yash101/tpbot/electronics/telepresence-bot.pdf

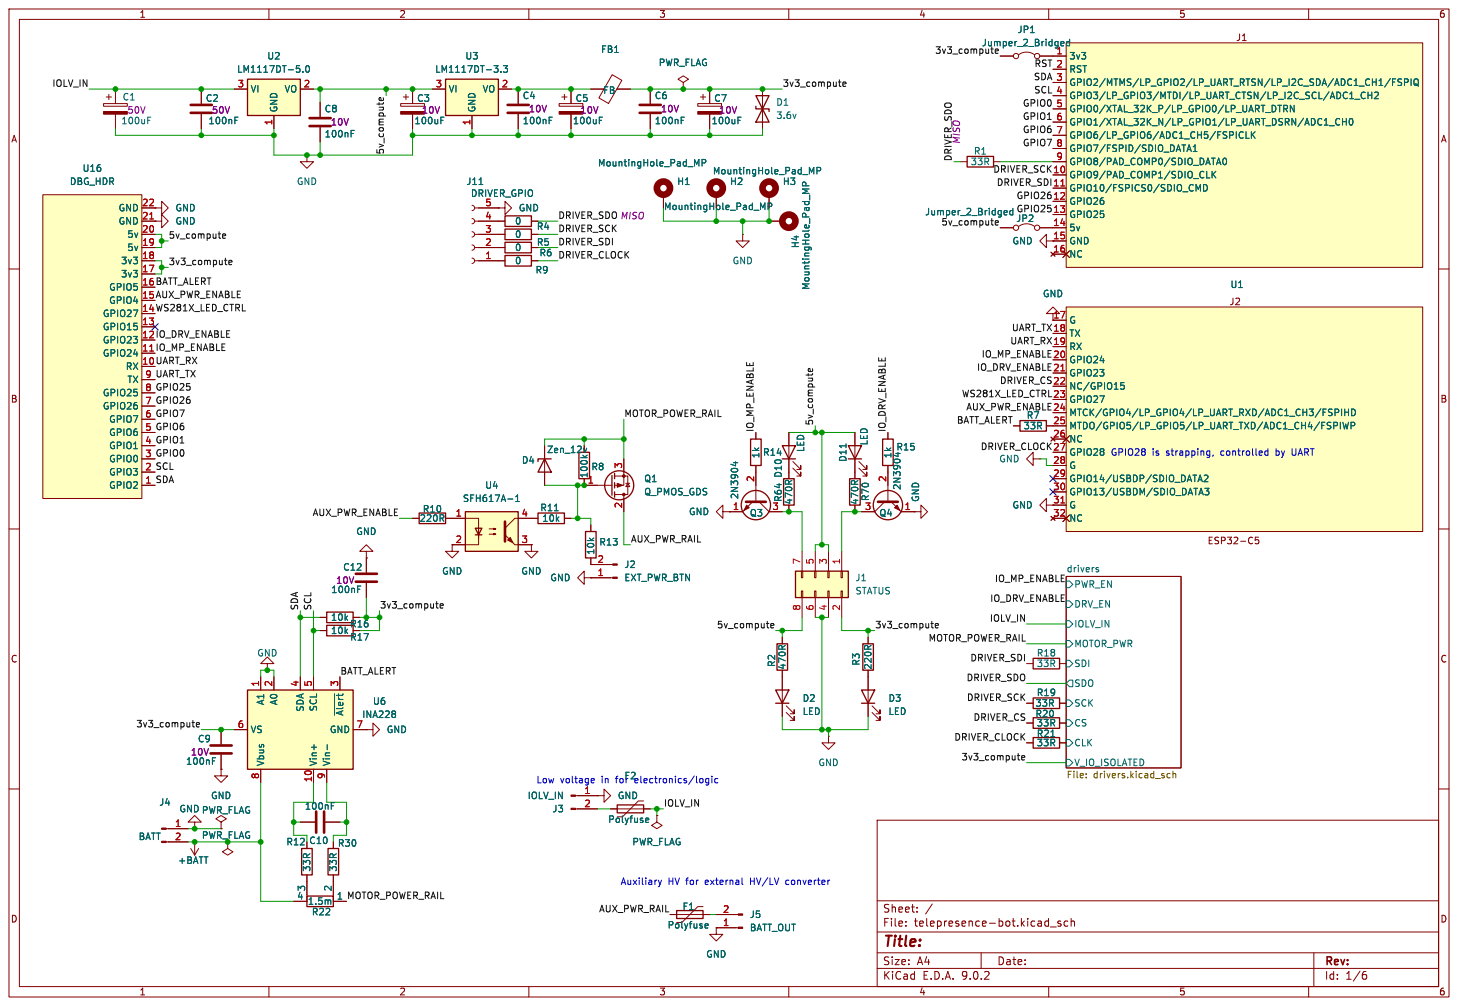
[picture p1: page 1]

3v3 1 RST 2 GPIO2/MTMS/LP_GPIO2/LP_UART_RTSN/LP_I2C_SDA/ADC1_CH1/FSPIQ 3 GPIO3/LP_GPIO3/MTDI/LP_UART_CTSN/LP_I2C_SCL/ADC1_CH2 4 GPIO0/XTAL_32K_P/LP_GPIO0/LP_UART_DTRN 5 GPIO1/XTAL_32K_N/LP_GPIO1/LP_UART_DSRN/ADC1_CH0 6 GPIO6/LP_GPIO6/ADC1_CH5/FSPICLK 7 GPIO7/FSPID/SDIO_DATA1 8 GPIO8/PAD_COMP0/SDIO_DATA0 9 GPIO9/PAD_COMP1/SDIO_CLK 10 GPIO10/FSPICS0/SDIO_CMD 11 GPIO26 12 GPIO25 13

5v 14 GND 15 NC 16 G
31 NC 32 GND
17 TX 18 RX 19 GPIO24 20 GPIO23 21 NC/GPIO15 22 GPIO27 23 MTCK/GPIO4/LP_GPIO4/LP_UART_RXD/ADC1_CH3/FSPIHD 24 MTDO/GPIO5/LP_GPIO5/LP_UART_TXD/ADC1_CH4/FSPIWP 25 NC 26 GPIO28 27 G

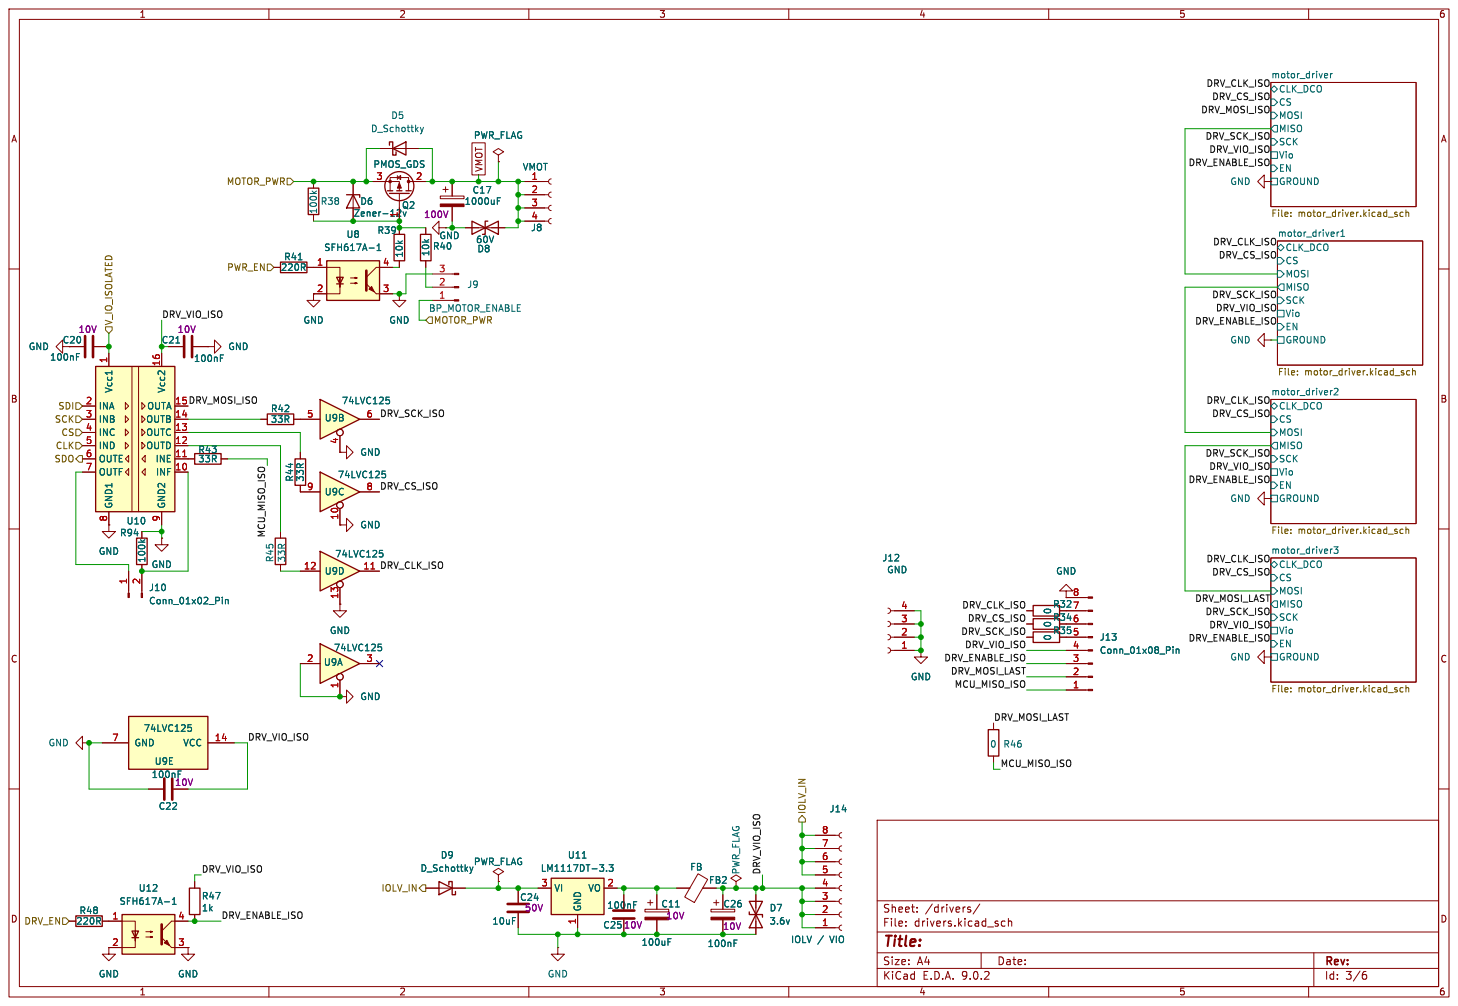
[picture p2: page 2]

9 OUTA 15 OUTB 14 OUTC 13 OUTD 12

Id: 3/6 Title: File: drivers.kicad_sch Sheet: /drivers/

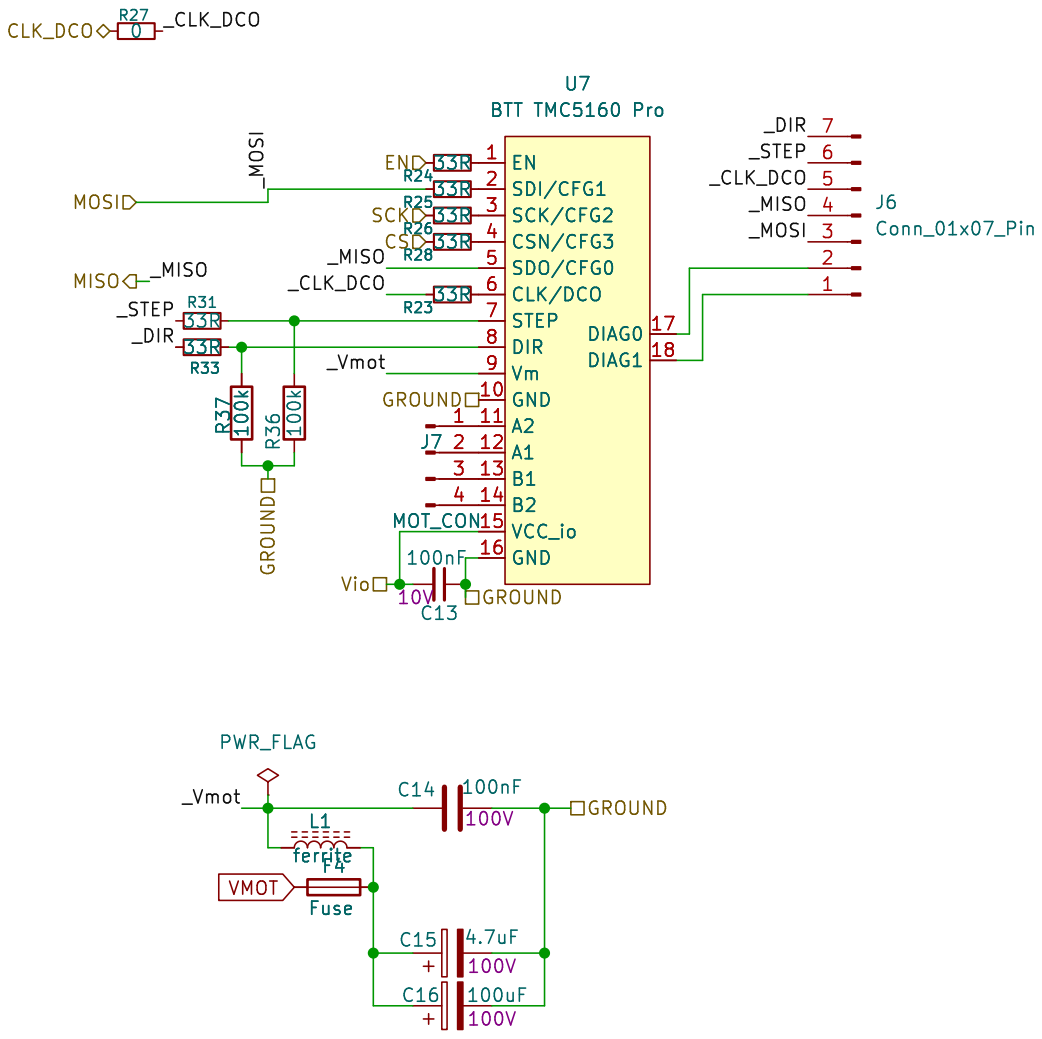
[picture p3: page 3]

Id: 2/6 Title: File: motor_driver.kicad_sch Sheet: /drivers/motor_driver1/

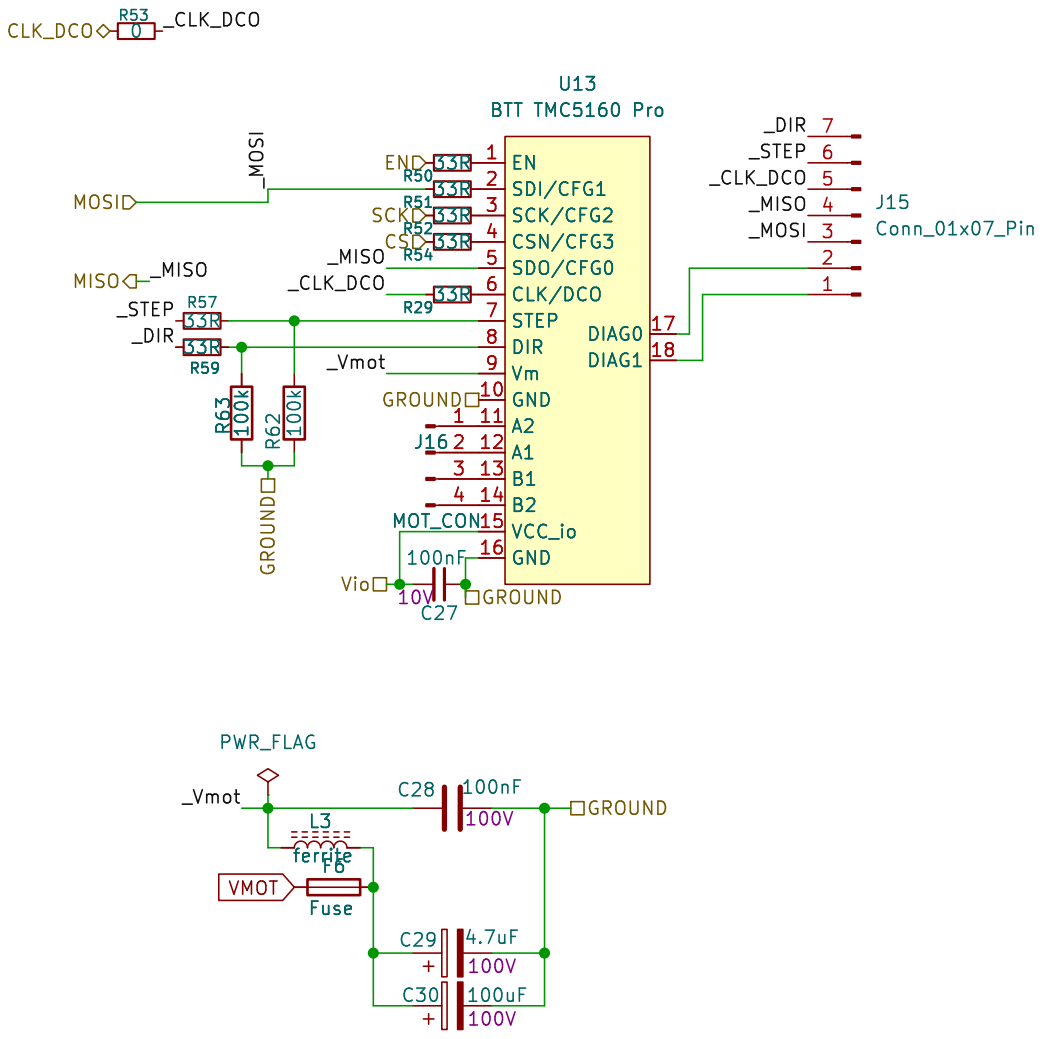
[picture p4: page 4]

Id: 3/6 Title: File: motor_driver.kicad_sch Sheet: /drivers/motor_driver/

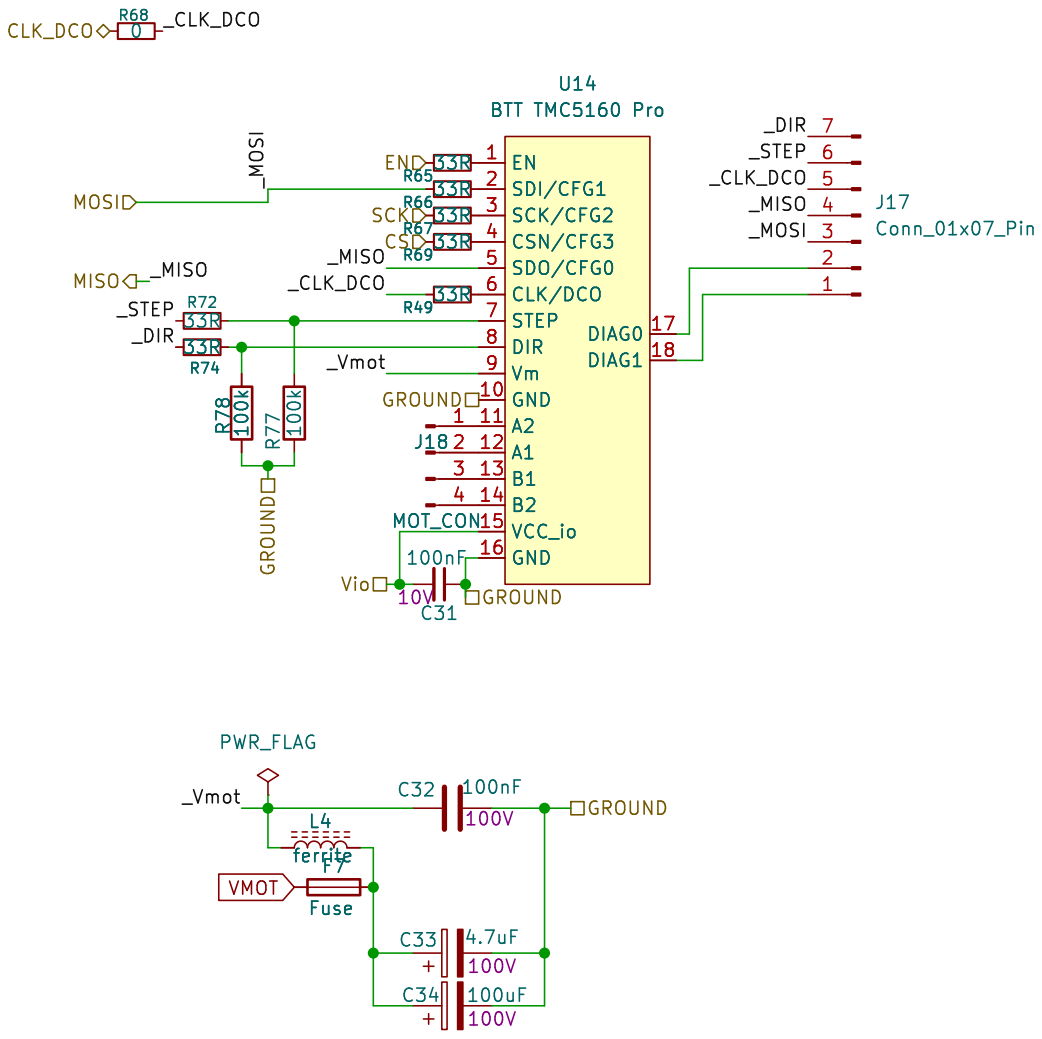
[picture p5: page 5]

Id: 4/6 Title: File: motor_driver.kicad_sch Sheet: /drivers/motor_driver2/

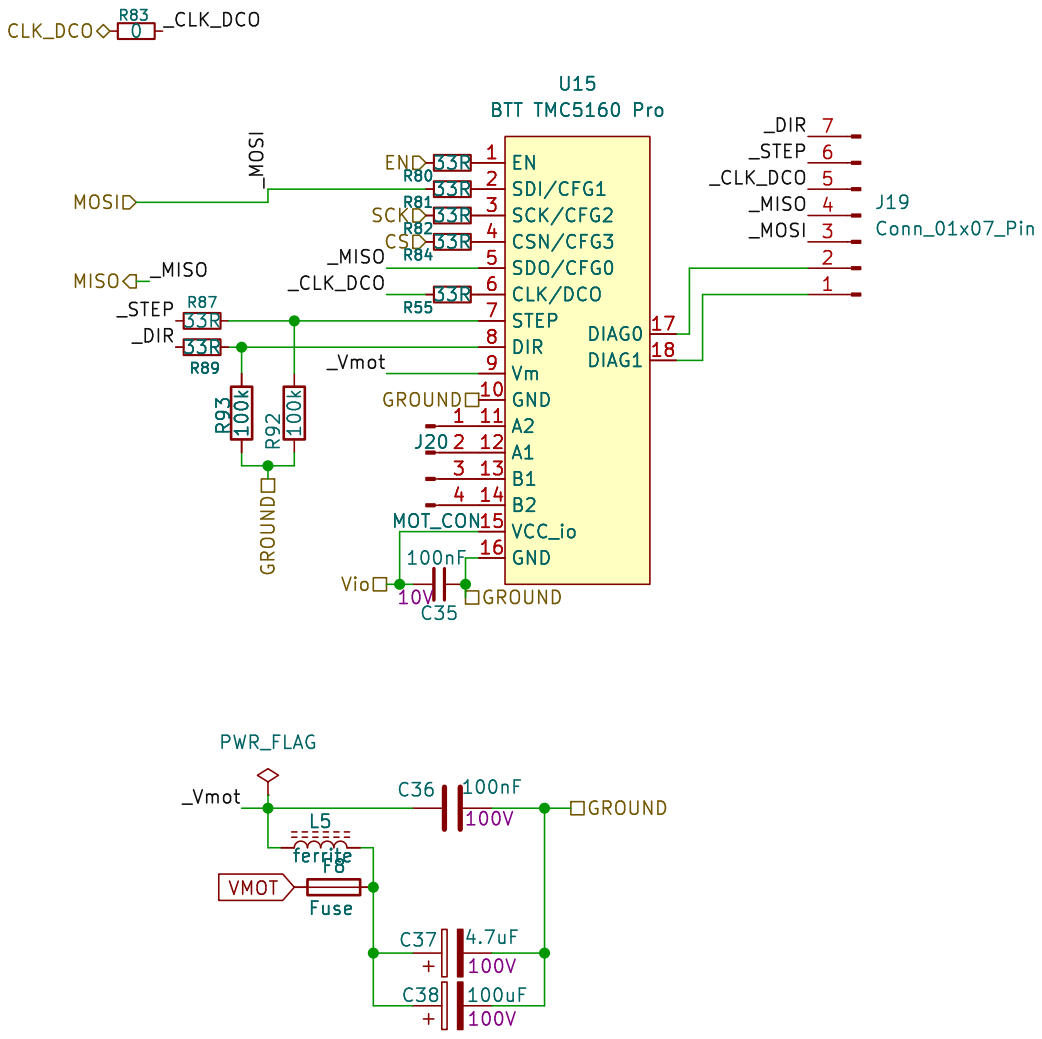
[picture p6: page 6]

Id: 5/6 Title: File: motor_driver.kicad_sch Sheet: /drivers/motor_driver3/
