yash101/tpbot/electronics/telepresence-bot.kicad_pcb

## KiCad design electronics/telepresence-bot.kicad_pcb (2025-08-20)

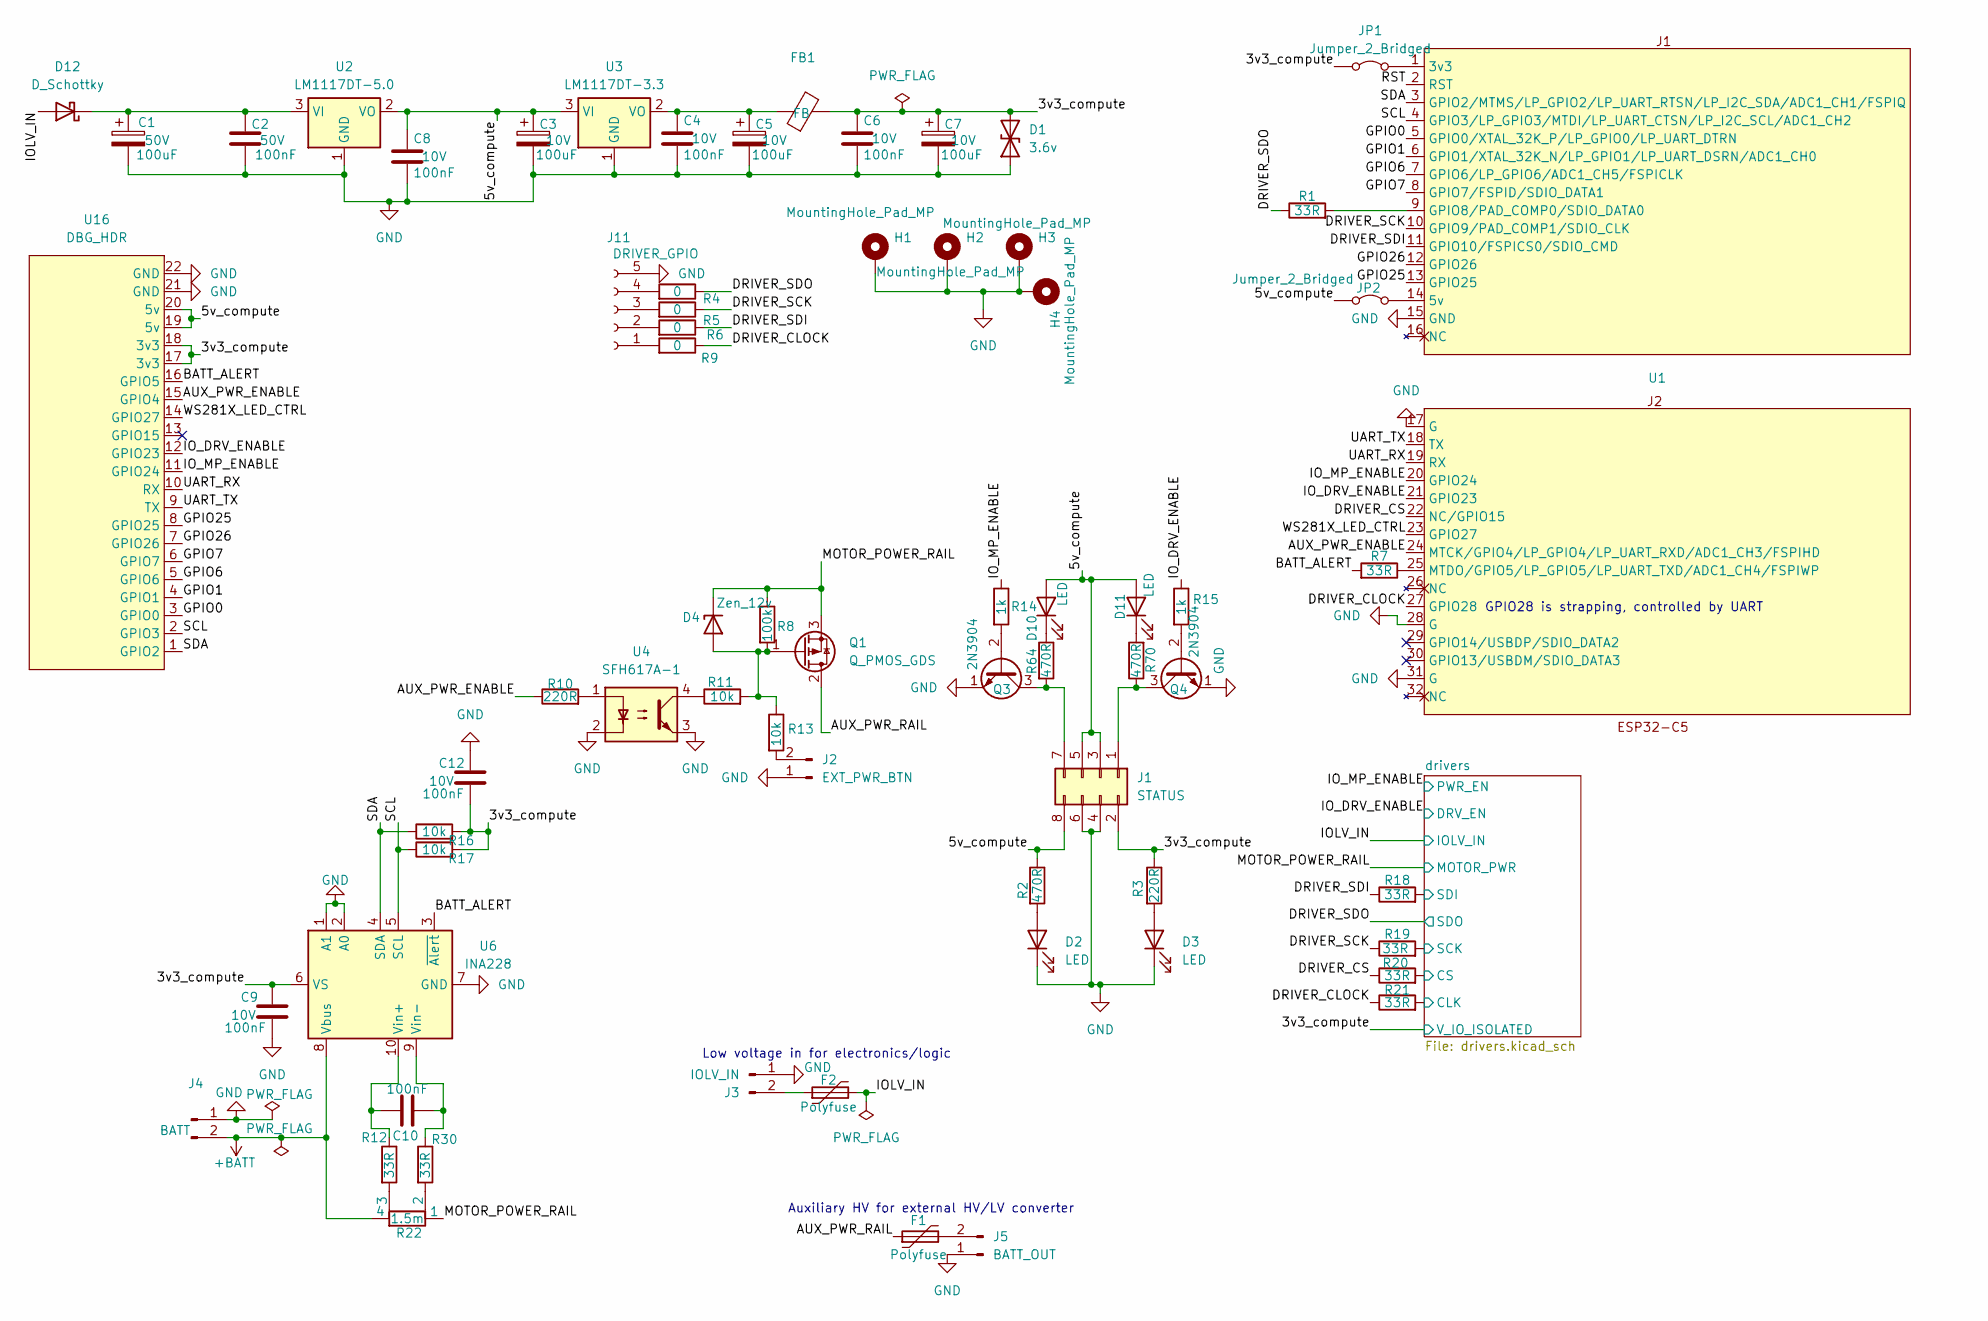
[picture p7: schematic telepresence-bot.kicad_sch]

Parts:
C1: 100uF; CP_Radial_D8.0mm_P5.00mm
C2, C10: 100nF; C_1206_3216Metric_Pad1.33x1.80mm_HandSolder
C3, C5, C7: 100uF; CP_Radial_D6.3mm_P2.50mm
C4, C6, C8, C9, C12: 100nF; C_0805_2012Metric_Pad1.18x1.45mm_HandSolder
D1: 3.6v; D_DO-41_SOD81_P2.54mm_Vertical_AnodeUp
D2, D3, D10, D11: LED; LED_D3.0mm
D4: Zen_12v; D_DO-41_SOD81_P2.54mm_Vertical_AnodeUp
D12: D_Schottky; D_DO-201AD_P5.08mm_Vertical_KathodeUp
F1, F2: Polyfuse; RV_Disc_D9mm_W5.2mm_P5mm
FB1: FB; L_1210_3225Metric_Pad1.42x2.65mm_HandSolder
H1, H2, H3, H4: MountingHole_Pad_MP; MountingHole_4.3mm_M4_ISO7380
J1: STATUS; PinSocket_2x04_P2.54mm_Vertical
J2: EXT_PWR_BTN; PinHeader_1x02_P2.54mm_Vertical
J3: IOLV_IN; PinHeader_1x02_P2.54mm_Vertical
J4: BATT; BATT_CONNECTOR
J5: BATT_OUT; PinSocket_1x02_P2.54mm_Vertical
J11: DRIVER_GPIO; PinSocket_1x05_P2.54mm_Vertical
JP1, JP2: Jumper_2_Bridged; PinSocket_1x02_P2.54mm_Vertical
Q1: Q_PMOS_GDS; TO-220-3_Vertical
Q3, Q4: 2N3904; TO-92_Inline_Wide
R1, R7, R12, R18, R19, R20, R21, R30: 33R; R_0805_2012Metric_Pad1.20x1.40mm_HandSolder
R2, R64, R70: 470R; R_Axial_DIN0204_L3.6mm_D1.6mm_P1.90mm_Vertical
R3, R10: 220R; R_Axial_DIN0204_L3.6mm_D1.6mm_P1.90mm_Vertical
R4, R5, R6, R9: 0; SolderJumper-2_P1.3mm_Open_Pad1.0x1.5mm
R8: 100k; R_0805_2012Metric_Pad1.20x1.40mm_HandSolder
R11, R13, R16, R17: 10k; R_0805_2012Metric_Pad1.20x1.40mm_HandSolder
R14, R15: 1k; R_Axial_DIN0204_L3.6mm_D1.6mm_P1.90mm_Vertical
R22: 1.5m; R_Shunt_Vishay_WSKW0612
U1: ESP32-C5-DevKitC-1-v1.2
U2: LM1117DT-5.0; TO-220-3_Vertical
U3: LM1117DT-3.3; TO-220-3_Vertical
U4: SFH617A-1; DIP-4_W7.62mm
U6: INA228; VSSOP-10_3x3mm_P0.5mm
U16: DBG_HDR; PinSocket_2x11_P2.54mm_Vertical

Connections:
+BATT: J4.2, R22.4, U6.8 (Vbus)
/3v3_compute: C6.1, C7.1, C9.1, C12.2, D1.2 (A2), FB1.2, J1.2, JP1.1 (A), R3.1, R16.2, R17.2, U6.6 (VS), U16.17 (3v3), U16.18 (3v3); also elsewhere on the board
/5v_compute: C3.1, C8.1, D10.2 (A), D11.2 (A), J1.3, J1.5, J1.8, JP2.1 (A), R2.1, U2.2 (VO), U3.3 (VI), U16.19 (5v), U16.20 (5v)
/AUX_PWR_ENABLE: R10.1, U1.24 (MTCK/GPIO4/LP_GPIO4/LP_UART_RXD/ADC1_CH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), U16.15 (GPIO4)
/AUX_PWR_RAIL: F1.1, Q1.2 (D)
/BATT_ALERT: R7.2, U6.3 (~Alert), U16.16 (GPIO5)
/DRIVER_CLOCK: R9.1, R21.1, U1.27 (GPIO28)
/DRIVER_CS: R20.1, U1.22 (NC/GPIO15)
/DRIVER_SCK: R5.1, R19.1, U1.10 (GPIO9/PAD_COMP1/SDIO_CLK)
/DRIVER_SDI: R6.1, R18.1, U1.11 (GPIO10/FSPICS0/SDIO_CMD)
/DRIVER_SDO: R1.1, R4.1; also elsewhere on the board
/GPIO0: U1.5 (GPIO0/XTAL_32K_P/LP_GPIO0/LP_UART_DTRN), U16.3 (GPIO0)
/GPIO1: U1.6 (GPIO1/XTAL_32K_N/LP_GPIO1/LP_UART_DSRN/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), U16.4 (GPIO1)
/GPIO6: U1.7 (GPIO6/LP_GPIO6/ADC1_CH5/FSPICLK), U16.5 (GPIO6)
/GPIO7: U1.8 (GPIO7/FSPID/SDIO_DATA1), U16.6 (GPIO7)
/GPIO25: U1.13 (GPIO25), U16.8 (GPIO25)
/GPIO26: U1.12 (GPIO26), U16.7 (GPIO26)
/IOLV_IN: D12.2 (A), F2.2; also elsewhere on the board
/IO_DRV_ENABLE: R15.1, U1.21 (GPIO23), U16.12 (GPIO23); also elsewhere on the board
/IO_MP_ENABLE: R14.1, U1.20 (GPIO24), U16.11 (GPIO24); also elsewhere on the board
/MOTOR_POWER_RAIL: D4.1 (K), Q1.3 (S), R8.1, R22.1; also elsewhere on the board
/RST: U1.2 (RST)
/SCL: R17.1, U1.4 (GPIO3/LP_GPIO3/MTDI/LP_UART_CTSN/LP_I2C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), U6.5 (SCL), U16.2 (GPIO3)
/SDA: R16.1, U1.3 (GPIO2/MTMS/LP_GPIO2/LP_UART_RTSN/LP_I2C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), U6.4 (SDA), U16.1 (GPIO2)
/UART_RX: U1.19 (RX), U16.10 (RX)
/UART_TX: U1.18 (TX), U16.9 (TX)
/WS281X_LED_CTRL: U1.23 (GPIO27), U16.14 (GPIO27)
/drivers/CLK: R21.2; also elsewhere on the board
/drivers/CS: R20.2; also elsewhere on the board
/drivers/SCK: R19.2; also elsewhere on the board
/drivers/SDI: R18.2; also elsewhere on the board
GND: C1.2, C2.2, C3.2, C4.2, C5.2, C6.2, C7.2, C8.2, C9.2, C12.1, D1.1 (A1), D2.1 (K), D3.1 (K), H1.MP, H2.MP, H3.MP, H4.MP, J1.4, J1.6, J2.1, J3.1, J4.1, J5.1, J11.5, Q3.1 (E), Q4.1 (E), U1.15 (GND), U1.17 (G), U1.28 (G), U1.31 (G), U2.1 (GND), U3.1 (GND), U4.2, U4.3, U6.1 (A1), U6.2 (A0), U6.7 (GND), U16.21 (GND), U16.22 (GND); also elsewhere on the board
unnamed: D2.2 (A), R2.2
unnamed: D3.2 (A), R3.2
unnamed: D4.2 (A), Q1.1 (G), R8.2, R11.2, R13.1
unnamed: D10.1 (K), R64.1
unnamed: D11.1 (K), R70.2
unnamed: C1.1, C2.1, D12.1 (K), U2.3 (VI)
unnamed: J1.1, Q4.3 (C), R70.1
unnamed: J1.7, Q3.3 (C), R64.2
unnamed: J2.2, R13.2
unnamed: F2.1, J3.2
unnamed: F1.2, J5.2
unnamed: J11.1, R9.2
unnamed: J11.2, R6.2
unnamed: J11.3, R5.2
unnamed: J11.4, R4.2
unnamed: JP1.2 (B), U1.1 (3v3)
unnamed: JP2.2 (B), U1.14 (5v)
unnamed: Q3.2 (B), R14.2
unnamed: Q4.2 (B), R15.2
unnamed: R10.2, U4.1
unnamed: R11.1, U4.4
unnamed: R12.2, R22.3
unnamed: R22.2, R30.2
unnamed: R1.2, U1.9 (GPIO8/PAD_COMP0/SDIO_DATA0)
unnamed: R7.1, U1.25 (MTDO/GPIO5/LP_GPIO5/LP_UART_TXD/ADC1_CH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)
unnamed: C4.1, C5.1, FB1.1, U3.2 (VO)
unnamed: C10.1, R12.1, U6.10 (Vin+)
unnamed: C10.2, R30.1, U6.9 (Vin-)

Notes on the sheet:
Auxiliary HV for external HV/LV converter
GPIO28 is strapping, controlled by UART
Low voltage in for electronics/logic

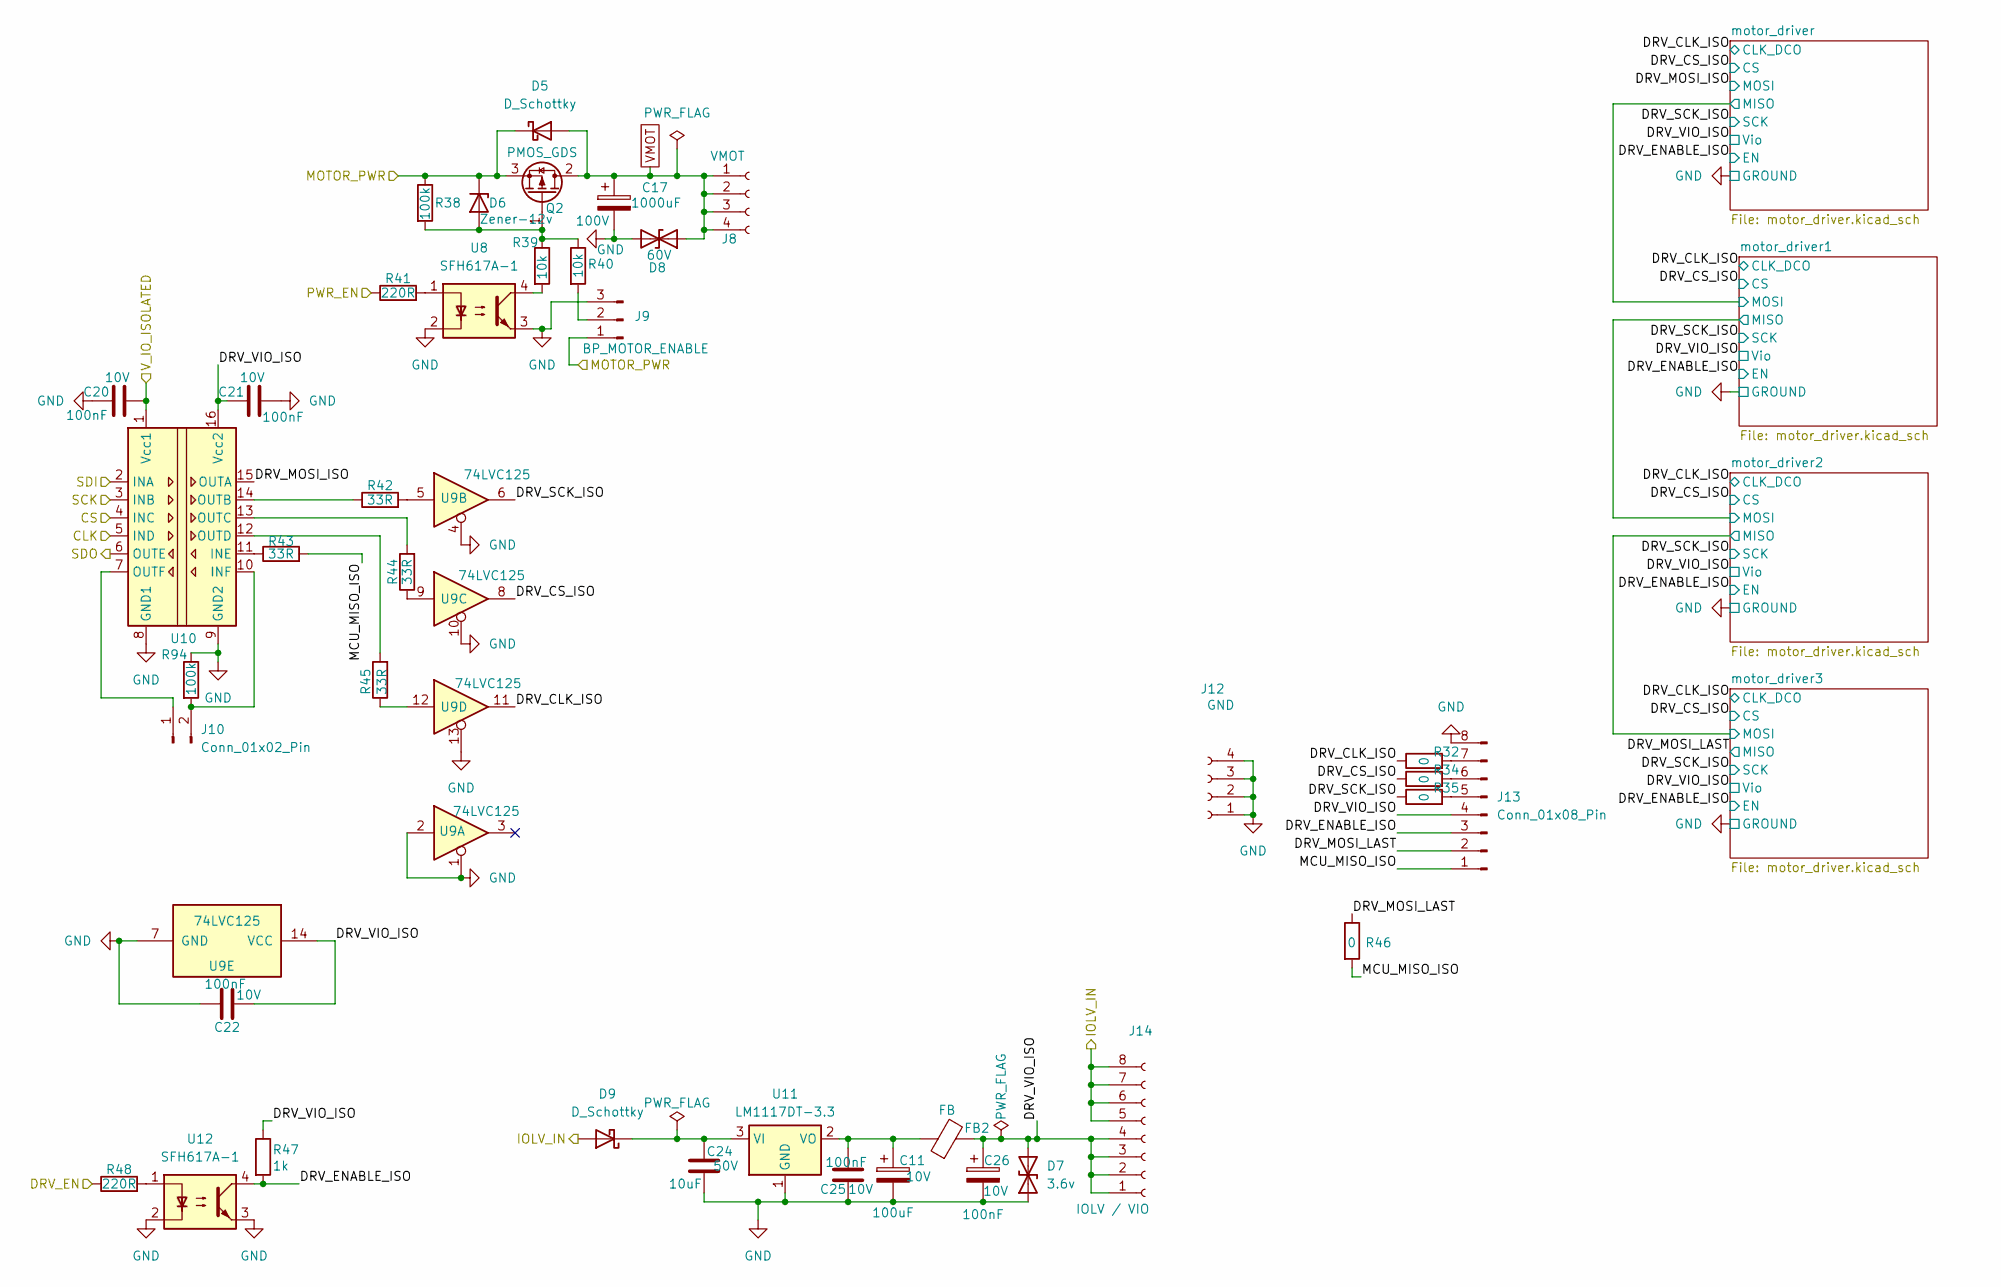
[picture p8: schematic drivers.kicad_sch]

Parts:
C11: 100uF; CP_Radial_D6.3mm_P2.50mm
C17: 1000uF; CP_Radial_D18.0mm_P7.50mm
C20, C21, C22, C25, C26: 100nF; C_0805_2012Metric_Pad1.18x1.45mm_HandSolder
C24: 10uF; CP_Radial_D5.0mm_P2.50mm
D5, D9: D_Schottky; D_DO-201AD_P5.08mm_Vertical_KathodeUp
D6: Zener-12v; D_DO-41_SOD81_P2.54mm_Vertical_AnodeUp
D7: 3.6v; D_DO-41_SOD81_P2.54mm_Vertical_AnodeUp
D8: 60V; D_DO-201AD_P5.08mm_Vertical_KathodeUp
FB2: FB; L_1210_3225Metric_Pad1.42x2.65mm_HandSolder
J8: VMOT; PinSocket_1x04_P2.54mm_Vertical
J9: BP_MOTOR_ENABLE; PinSocket_1x03_P2.54mm_Vertical
J10: Conn_01x02_Pin; PinSocket_1x02_P2.54mm_Vertical
J12: GND; PinSocket_1x04_P2.54mm_Vertical
J13: Conn_01x08_Pin; PinSocket_2x04_P2.54mm_Vertical
J14: IOLV / VIO; PinSocket_2x04_P2.54mm_Vertical
Q2: PMOS_GDS; TO-220-3_Vertical
R32, R34, R35, R46: 0; SolderJumper-2_P1.3mm_Open_Pad1.0x1.5mm
R38, R94: 100k; R_0805_2012Metric_Pad1.20x1.40mm_HandSolder
R39, R40: 10k; R_0805_2012Metric_Pad1.20x1.40mm_HandSolder
R41: 220R; R_Axial_DIN0204_L3.6mm_D1.6mm_P2.54mm_Vertical
R42, R43, R44, R45: 33R; R_0805_2012Metric_Pad1.20x1.40mm_HandSolder
R47: 1k; R_Axial_DIN0204_L3.6mm_D1.6mm_P2.54mm_Vertical
R48: 220R; R_Axial_DIN0204_L3.6mm_D1.6mm_P1.90mm_Vertical
U8, U12: SFH617A-1; DIP-4_W7.62mm
U9: 74LVC125; DIP-14_W7.62mm
U10: ISO7762DBQ; SSOP-16_3.9x4.9mm_P0.635mm
U11: LM1117DT-3.3; TO-220-3_Vertical

Connections:
/3v3_compute: C20.2, U10.1 (Vcc1); also elsewhere on the board
/DRIVER_SDO: U10.6 (OUTE); also elsewhere on the board
/IOLV_IN: D9.2 (A), J14.5, J14.6, J14.7, J14.8; also elsewhere on the board
/IO_DRV_ENABLE: R48.1; also elsewhere on the board
/IO_MP_ENABLE: R41.1; also elsewhere on the board
/MOTOR_POWER_RAIL: D5.1 (K), D6.1 (K), J9.1, Q2.3 (S), R38.1; also elsewhere on the board
/drivers/CLK: U10.5 (IND); also elsewhere on the board
/drivers/CS: U10.4 (INC); also elsewhere on the board
/drivers/DRV_CLK_ISO: R32.1, U9.11; also elsewhere on the board
/drivers/DRV_CS_ISO: R34.1, U9.8; also elsewhere on the board
/drivers/DRV_ENABLE_ISO: J13.3, R47.2, U12.4; also elsewhere on the board
/drivers/DRV_MOSI_ISO: U10.15 (OUTA); also elsewhere on the board
/drivers/DRV_MOSI_LAST: J13.2, R46.1; also elsewhere on the board
/drivers/DRV_SCK_ISO: R35.1, U9.6; also elsewhere on the board
/drivers/DRV_VIO_ISO: C21.1, C22.1, C26.1, D7.2 (A2), FB2.2, J13.4, J14.1, J14.2, J14.3, J14.4, R47.1, U9.14 (VCC), U10.16 (Vcc2); also elsewhere on the board
/drivers/MCU_MISO_ISO: J13.1, R43.2, R46.2
/drivers/SCK: U10.3 (INB); also elsewhere on the board
/drivers/SDI: U10.2 (INA); also elsewhere on the board
GND: C11.2, C17.2, C20.1, C21.2, C22.2, C24.2, C25.2, C26.2, D7.1 (A1), D8.2 (A2), J9.3, J12.1, J12.2, J12.3, J12.4, J13.8, R94.1, U8.2, U8.3, U9.1, U9.2, U9.4, U9.7 (GND), U9.10, U9.13, U10.8 (GND1), U10.9 (GND2), U11.1 (GND), U12.2, U12.3; also elsewhere on the board
unnamed: D6.2 (A), Q2.1 (G), R38.2, R39.1, R40.1
unnamed: C24.1, D9.1 (K), U11.3 (VI)
unnamed: J9.2, R40.2
unnamed: J10.1, U10.7 (OUTF)
unnamed: J10.2, R94.2, U10.10 (INF)
unnamed: J13.5, R35.2
unnamed: J13.6, R34.2
unnamed: J13.7, R32.2
unnamed: R39.2, U8.4
unnamed: R41.2, U8.1
unnamed: R42.2, U9.5
unnamed: R44.1, U9.9
unnamed: R45.1, U9.12
unnamed: R48.2, U12.1
unnamed: R43.1, U10.11 (INE)
unnamed: R42.1, U10.14 (OUTB)
unnamed: R44.2, U10.13 (OUTC)
unnamed: R45.2, U10.12 (OUTD)
unnamed: C11.1, C25.1, FB2.1, U11.2 (VO)
VMOT: C17.1, D5.2 (A), D8.1 (A1), J8.1, J8.2, J8.3, J8.4, Q2.2 (D); also elsewhere on the board

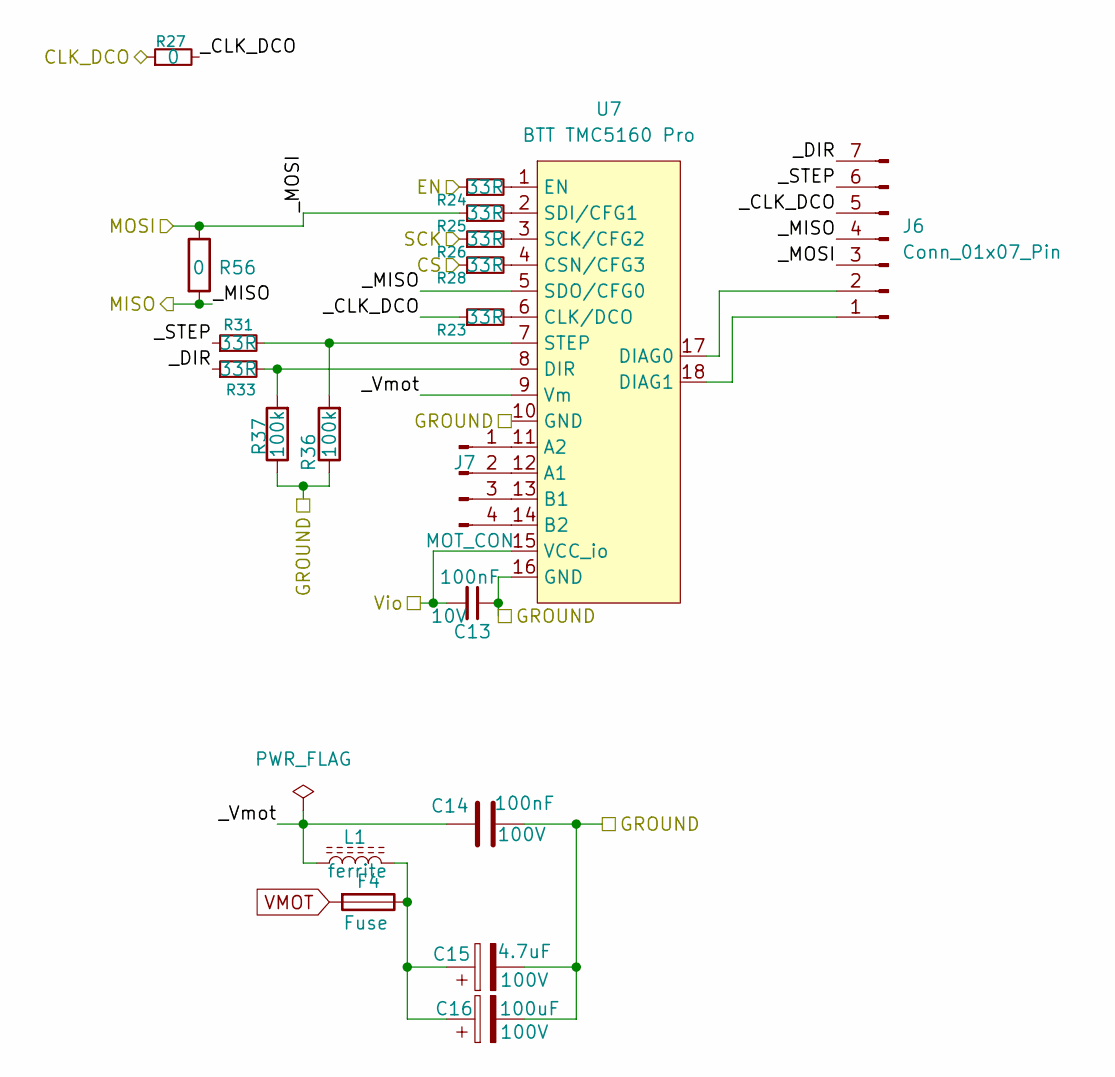
[picture p9: schematic motor_driver.kicad_sch]

Parts:
C13: 100nF; C_0805_2012Metric_Pad1.18x1.45mm_HandSolder
C14: 100nF; C_1206_3216Metric_Pad1.33x1.80mm_HandSolder
C15: 4.7uF; CP_Radial_D5.0mm_P2.50mm
C16: 100uF; CP_Radial_D8.0mm_P5.00mm
F4: Fuse; XFCN XF-508P-A-B
J6: Conn_01x07_Pin; PinSocket_1x07_P2.54mm_Vertical
J7: MOT_CON; PinSocket_1x04_P2.54mm_Vertical
L1: ferrite; L_1210_3225Metric_Pad1.42x2.65mm_HandSolder
R23, R24, R25, R26, R28, R31, R33: 33R; R_0805_2012Metric_Pad1.20x1.40mm_HandSolder
R27, R56: 0; SolderJumper-2_P1.3mm_Open_Pad1.0x1.5mm
R36, R37: 100k; R_0805_2012Metric_Pad1.20x1.40mm_HandSolder
U7: BTT TMC5160 Pro; BTT-TMC5160PRO-v1.0

Connections:
/drivers/DRV_CLK_ISO: R27.1; also elsewhere on the board
/drivers/DRV_CS_ISO: R28.1; also elsewhere on the board
/drivers/DRV_ENABLE_ISO: R24.1; also elsewhere on the board
/drivers/DRV_SCK_ISO: R26.1; also elsewhere on the board
/drivers/DRV_VIO_ISO: C13.2, U7.15 (VCC_io); also elsewhere on the board
/drivers/motor_driver1/_CLK_DCO: J6.5, R23.1, R27.2
/drivers/motor_driver1/_DIR: J6.7, R33.1
/drivers/motor_driver1/_MISO: J6.4, R56.2, U7.5 (SDO/CFG0); also elsewhere on the board
/drivers/motor_driver1/_STEP: J6.6, R31.1
/drivers/motor_driver1/_Vmot: C14.1, L1.1, U7.9 (Vm)
/drivers/motor_driver/_MISO: J6.3, R25.1, R56.1; also elsewhere on the board
GND: C13.1, C14.2, C15.2, C16.2, R36.1, R37.1, U7.10 (GND), U7.16 (GND); also elsewhere on the board
unnamed: C15.1, C16.1, F4.1, L1.2
unnamed: J6.1, U7.18 (DIAG1)
unnamed: J6.2, U7.17 (DIAG0)
unnamed: J7.1, U7.11 (A2)
unnamed: J7.2, U7.12 (A1)
unnamed: J7.3, U7.13 (B1)
unnamed: J7.4, U7.14 (B2)
unnamed: R23.2, U7.6 (CLK/DCO)
unnamed: R28.2, U7.4 (CSN/CFG3)
unnamed: R33.2, R37.2, U7.8 (DIR)
unnamed: R24.2, U7.1 (EN)
unnamed: R26.2, U7.3 (SCK/CFG2)
unnamed: R25.2, U7.2 (SDI/CFG1)
unnamed: R31.2, R36.2, U7.7 (STEP)
VMOT: F4.2; also elsewhere on the board

Parts of its further copies:
C27, C31, C35: 100nF; C_0805_2012Metric_Pad1.18x1.45mm_HandSolder
C28, C32, C36: 100nF; C_1206_3216Metric_Pad1.33x1.80mm_HandSolder
C29, C33, C37: 4.7uF; CP_Radial_D5.0mm_P2.50mm
C30, C34, C38: 100uF; CP_Radial_D8.0mm_P5.00mm
F6, F7, F8: Fuse; XFCN XF-508P-A-B
J15, J17, J19: Conn_01x07_Pin; PinSocket_1x07_P2.54mm_Vertical
J16, J18, J20: MOT_CON; PinSocket_1x04_P2.54mm_Vertical
L3, L4, L5: ferrite; L_1210_3225Metric_Pad1.42x2.65mm_HandSolder
R29, R49, R50, R51, R52, R54, R55, R57, R59, R65, R66, R67, R69, R72, R74, R80, R81, R82, R84, R87, R89: 33R; R_0805_2012Metric_Pad1.20x1.40mm_HandSolder
R53, R58, R60, R61, R68, R83: 0; SolderJumper-2_P1.3mm_Open_Pad1.0x1.5mm
R62, R63, R77, R78, R92, R93: 100k; R_0805_2012Metric_Pad1.20x1.40mm_HandSolder
U13, U14, U15: BTT TMC5160 Pro; BTT-TMC5160PRO-v1.0

Connections of its further copies:
/drivers/DRV_CLK_ISO: R53.1, R68.1, R83.1; also elsewhere on the board
/drivers/DRV_CS_ISO: R54.1, R69.1, R84.1; also elsewhere on the board
/drivers/DRV_ENABLE_ISO: R50.1, R65.1, R80.1; also elsewhere on the board
/drivers/DRV_MOSI_ISO: J15.3, R51.1, R58.1; also elsewhere on the board
/drivers/DRV_MOSI_LAST: J19.4, R61.2, U15.5 (SDO/CFG0); also elsewhere on the board
/drivers/DRV_SCK_ISO: R52.1, R67.1, R82.1; also elsewhere on the board
/drivers/DRV_VIO_ISO: C27.2, C31.2, C35.2, U13.15 (VCC_io), U14.15 (VCC_io), U15.15 (VCC_io); also elsewhere on the board
/drivers/motor_driver1/_MISO: J17.3, R60.1, R66.1; also elsewhere on the board
/drivers/motor_driver2/_CLK_DCO: J17.5, R49.1, R68.2
/drivers/motor_driver2/_DIR: J17.7, R74.1
/drivers/motor_driver2/_MISO: J17.4, J19.3, R60.2, R61.1, R81.1, U14.5 (SDO/CFG0)
/drivers/motor_driver2/_STEP: J17.6, R72.1
/drivers/motor_driver2/_Vmot: C32.1, L4.1, U14.9 (Vm)
/drivers/motor_driver3/_CLK_DCO: J19.5, R55.1, R83.2
/drivers/motor_driver3/_DIR: J19.7, R89.1
/drivers/motor_driver3/_STEP: J19.6, R87.1
/drivers/motor_driver3/_Vmot: C36.1, L5.1, U15.9 (Vm)
/drivers/motor_driver/_CLK_DCO: J15.5, R29.1, R53.2
/drivers/motor_driver/_DIR: J15.7, R59.1
/drivers/motor_driver/_MISO: J15.4, R58.2, U13.5 (SDO/CFG0); also elsewhere on the board
/drivers/motor_driver/_STEP: J15.6, R57.1
/drivers/motor_driver/_Vmot: C28.1, L3.1, U13.9 (Vm)
GND: C27.1, C28.2, C29.2, C30.2, C31.1, C32.2, C33.2, C34.2, C35.1, C36.2, C37.2, C38.2, R62.1, R63.1, R77.1, R78.1, R92.1, R93.1, U13.10 (GND), U13.16 (GND), U14.10 (GND), U14.16 (GND), U15.10 (GND), U15.16 (GND); also elsewhere on the board
unnamed: C29.1, C30.1, F6.1, L3.2
unnamed: C33.1, C34.1, F7.1, L4.2
unnamed: C37.1, C38.1, F8.1, L5.2
unnamed: J15.1, U13.18 (DIAG1)
unnamed: J15.2, U13.17 (DIAG0)
unnamed: J16.1, U13.11 (A2)
unnamed: J16.2, U13.12 (A1)
unnamed: J16.3, U13.13 (B1)
unnamed: J16.4, U13.14 (B2)
unnamed: J17.1, U14.18 (DIAG1)
unnamed: J17.2, U14.17 (DIAG0)
unnamed: J18.1, U14.11 (A2)
unnamed: J18.2, U14.12 (A1)
unnamed: J18.3, U14.13 (B1)
unnamed: J18.4, U14.14 (B2)
unnamed: J19.1, U15.18 (DIAG1)
unnamed: J19.2, U15.17 (DIAG0)
unnamed: J20.1, U15.11 (A2)
unnamed: J20.2, U15.12 (A1)
unnamed: J20.3, U15.13 (B1)
unnamed: J20.4, U15.14 (B2)
unnamed: R29.2, U13.6 (CLK/DCO)
unnamed: R54.2, U13.4 (CSN/CFG3)
unnamed: R59.2, R63.2, U13.8 (DIR)
unnamed: R50.2, U13.1 (EN)
unnamed: R52.2, U13.3 (SCK/CFG2)
unnamed: R51.2, U13.2 (SDI/CFG1)
unnamed: R57.2, R62.2, U13.7 (STEP)
unnamed: R49.2, U14.6 (CLK/DCO)
unnamed: R69.2, U14.4 (CSN/CFG3)
unnamed: R74.2, R78.2, U14.8 (DIR)
unnamed: R65.2, U14.1 (EN)
unnamed: R67.2, U14.3 (SCK/CFG2)
unnamed: R66.2, U14.2 (SDI/CFG1)
unnamed: R72.2, R77.2, U14.7 (STEP)
unnamed: R55.2, U15.6 (CLK/DCO)
unnamed: R84.2, U15.4 (CSN/CFG3)
unnamed: R89.2, R93.2, U15.8 (DIR)
unnamed: R80.2, U15.1 (EN)
unnamed: R82.2, U15.3 (SCK/CFG2)
unnamed: R81.2, U15.2 (SDI/CFG1)
unnamed: R87.2, R92.2, U15.7 (STEP)
VMOT: F6.2, F7.2, F8.2; also elsewhere on the board

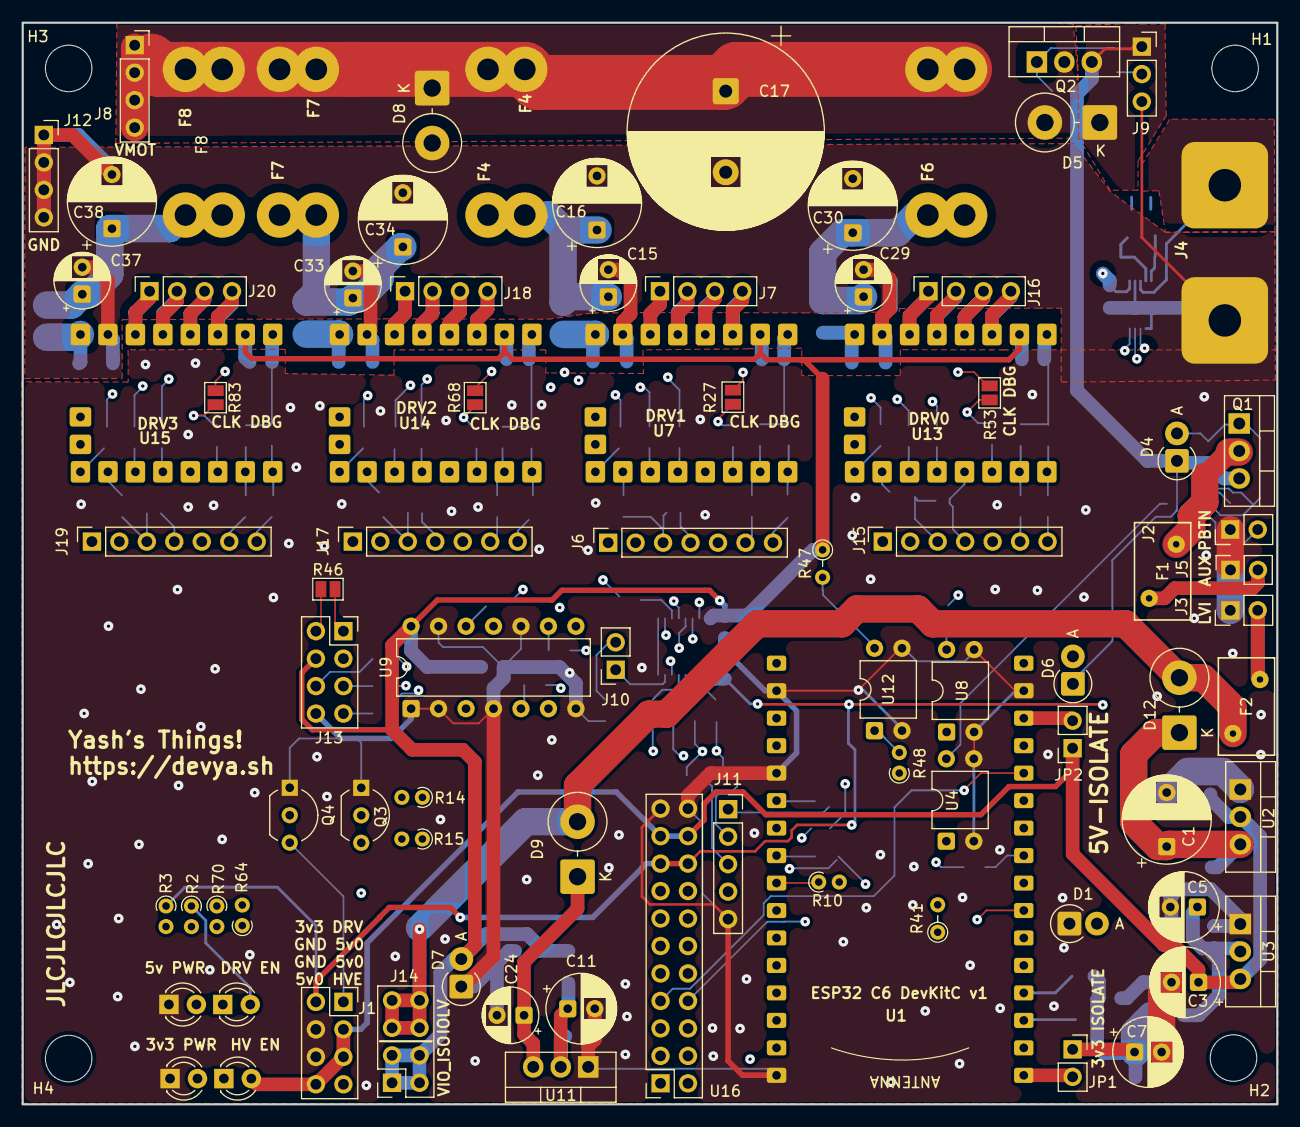
[picture p10: board telepresence-bot.kicad_pcb from above]

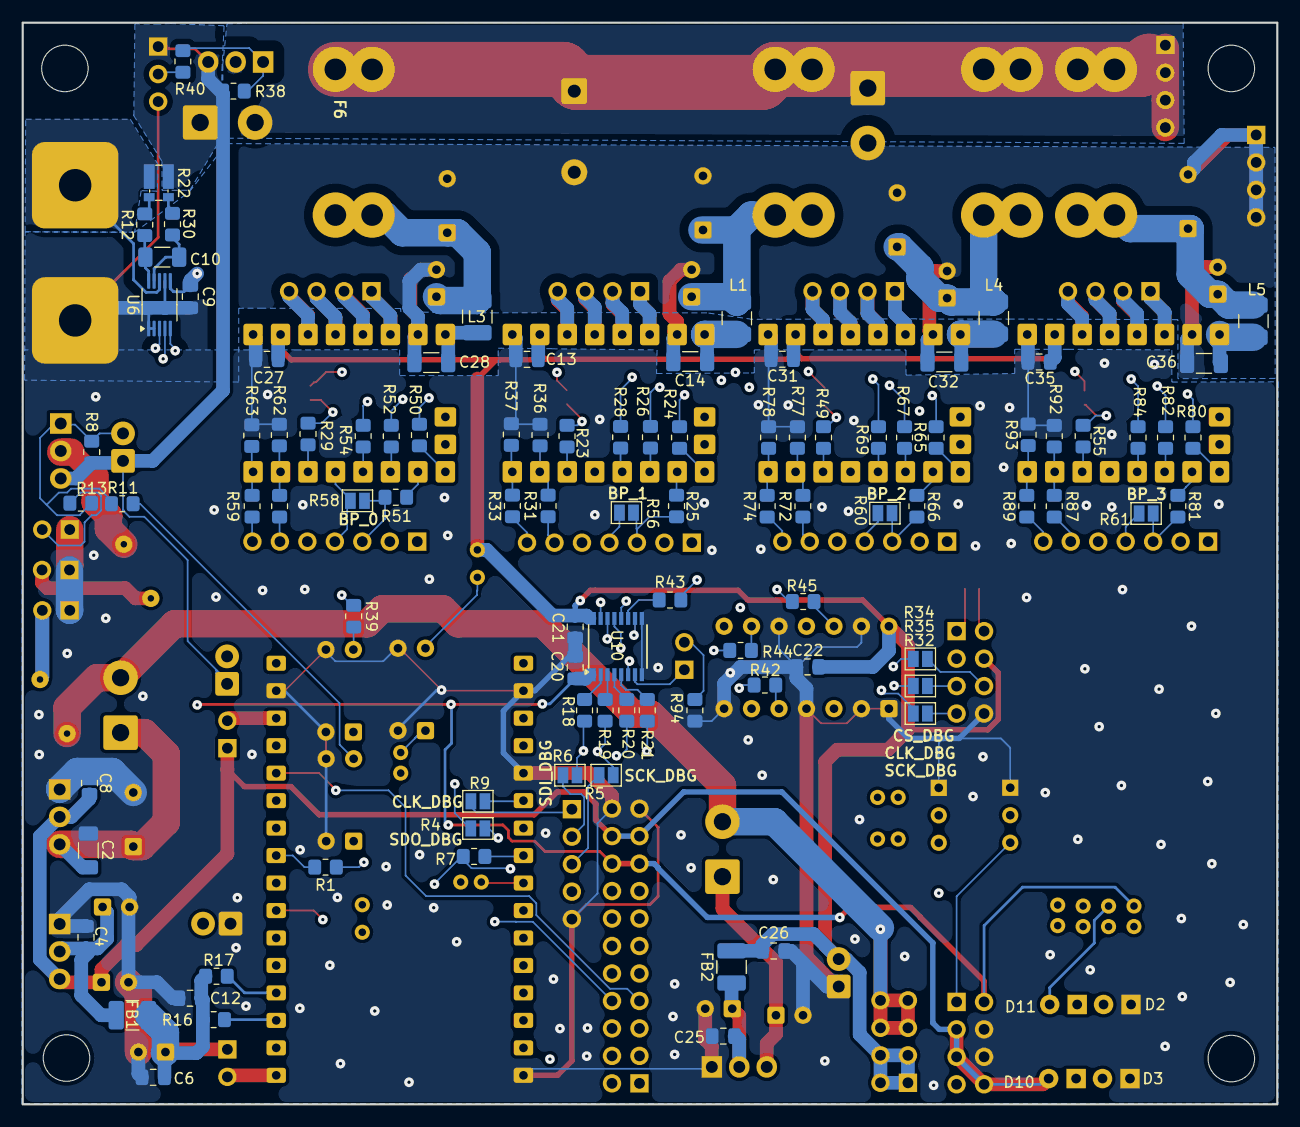
[picture p11: board telepresence-bot.kicad_pcb from below]

Board: 4 copper layers, 116.0 x 100.0 mm, 188 parts (97 on the bottom side), 162 nets.
