yash101/tpbot/(commit log)

2025-07-23 Checkpoint before switching to 0ohm jumpers
    [drivers.kicad_sch, power.kicad_sch, telepresence-bot.kicad_pcb, telepresence-bot.kicad_sch]
2025-07-29 saving before i nuke this shit
    [drivers.kicad_sch, motor_driver.kicad_sch, telepresence-bot-old.kicad_pcb, telepresence-bot.kicad_sch]
2025-07-30 Switching to a bigger PCB since cost seems negligible
    [drivers.kicad_sch, motor_driver.kicad_sch, telepresence-bot-old.kicad_pcb, telepresence-bot.kicad_pcb, telepresence-bot.kicad_sch]
2025-08-20 Updating electronics CAD post-production
    [bom-jlcpcb.csv, drivers.kicad_sch, motor_driver.kicad_sch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]
2025-08-21 Some vibe coding to set up project structure. Almost all of the code will be rewritten to my standards
    [drivers.kicad_sch, motor_driver.kicad_sch, telepresence-bot.kicad_sch]
